xPiTi/pillex-main/CAD/4.png

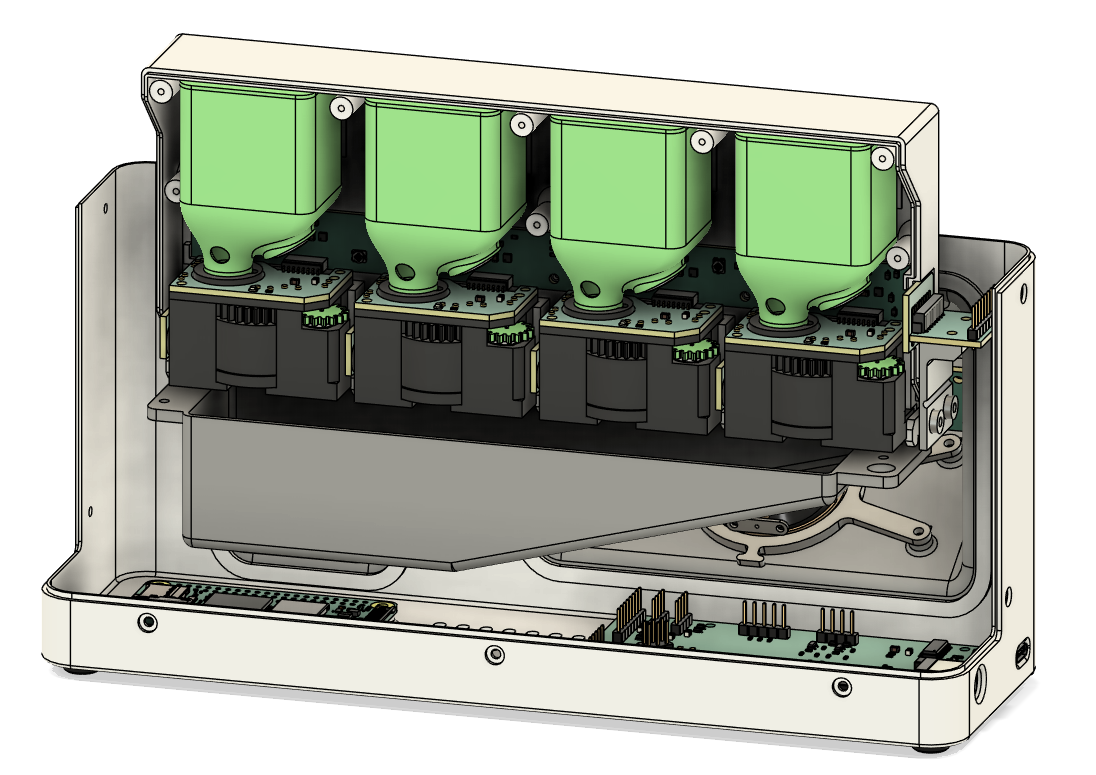
CAD/4.png
