xPiTi/pillex-main/CAD/5.png

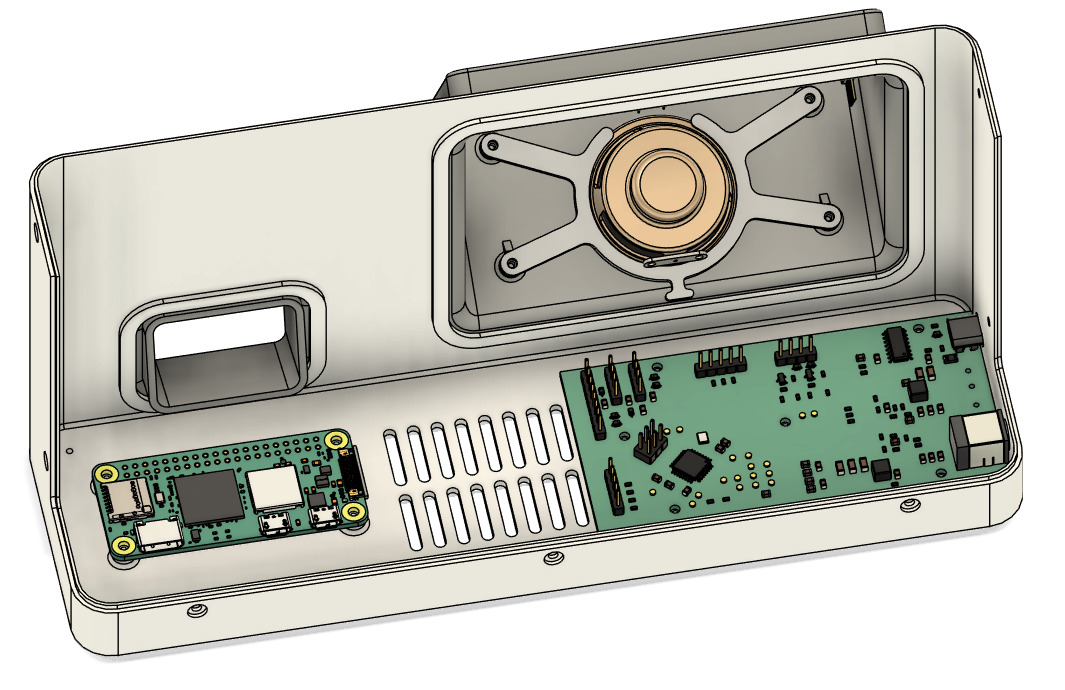
CAD/5.png
