xPiTi/pillex-main/README.md

# Pillex

Submission files for MSc project - Pillex - pill dispensing device

Read more at: https://paw3l.com/projects/pillex/
