xPiTi/pillex-main/CAD/1.png

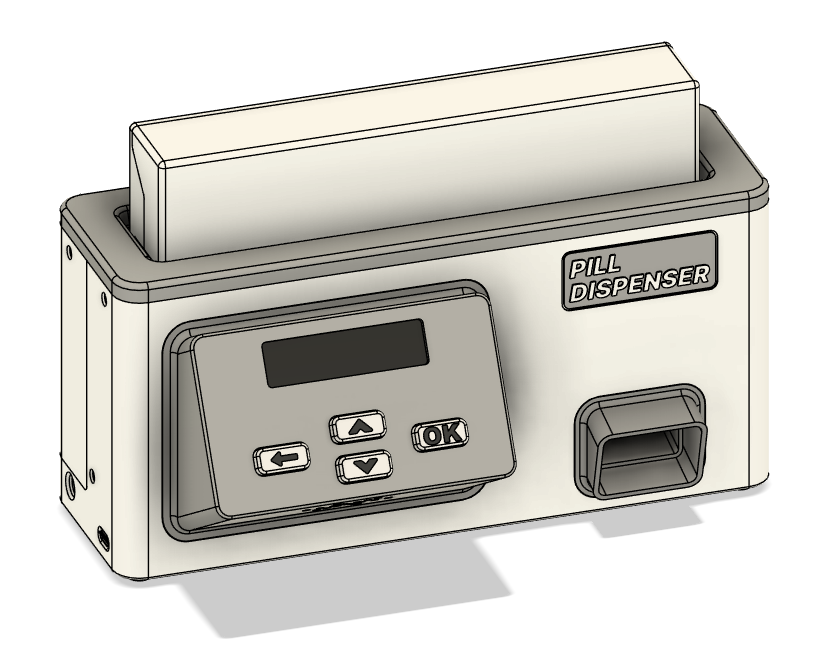
CAD/1.png
