xPiTi/pillex-main/CAD/2.png

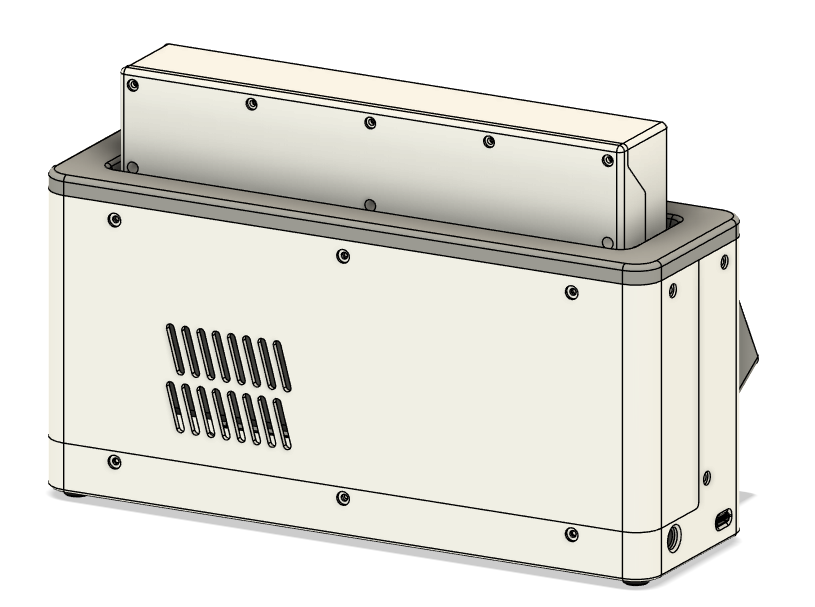
CAD/2.png
