xPiTi/pillex-main/CAD/3.png

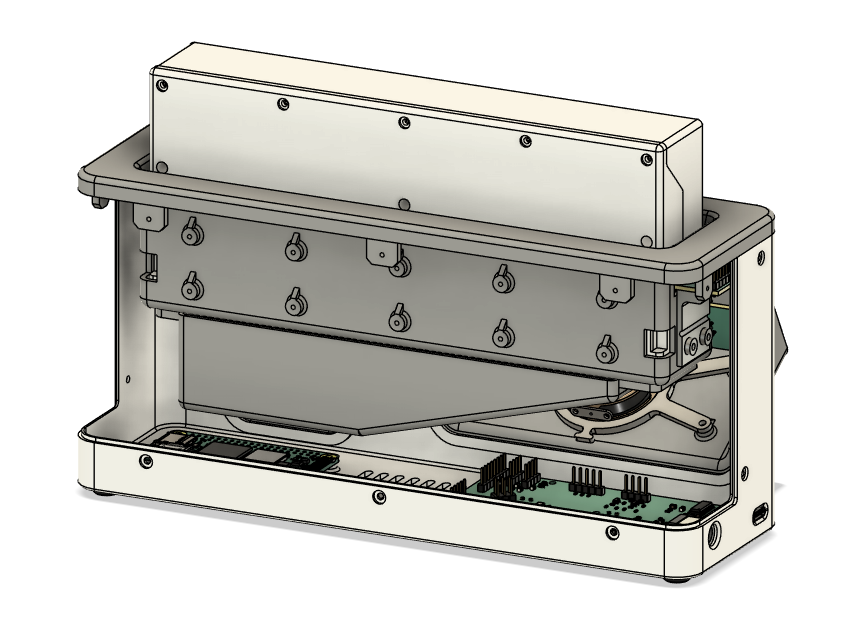
CAD/3.png
