xPiTi/pillex-main/CAD/6.png

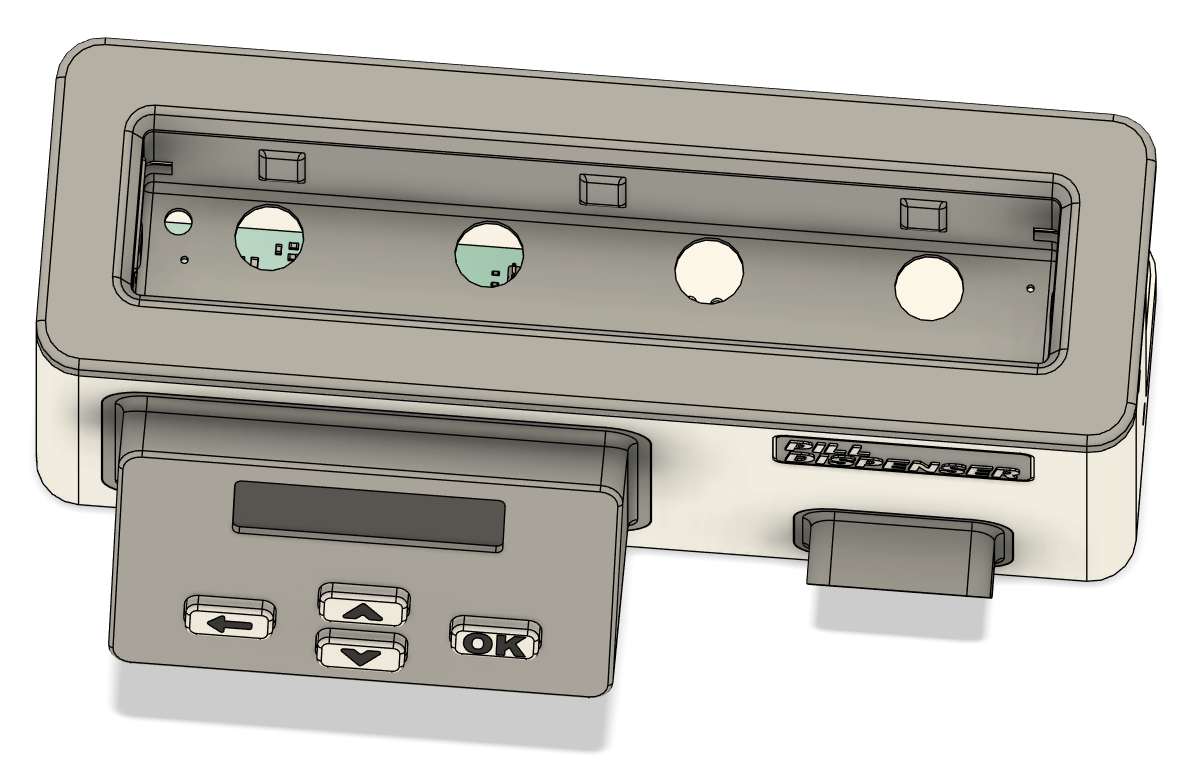
CAD/6.png
