xPiTi/pillex-main/PCB/PillDispenser.kicad_pcb

## KiCad design PCB/PillDispenser.kicad_pcb (2025-11-02)

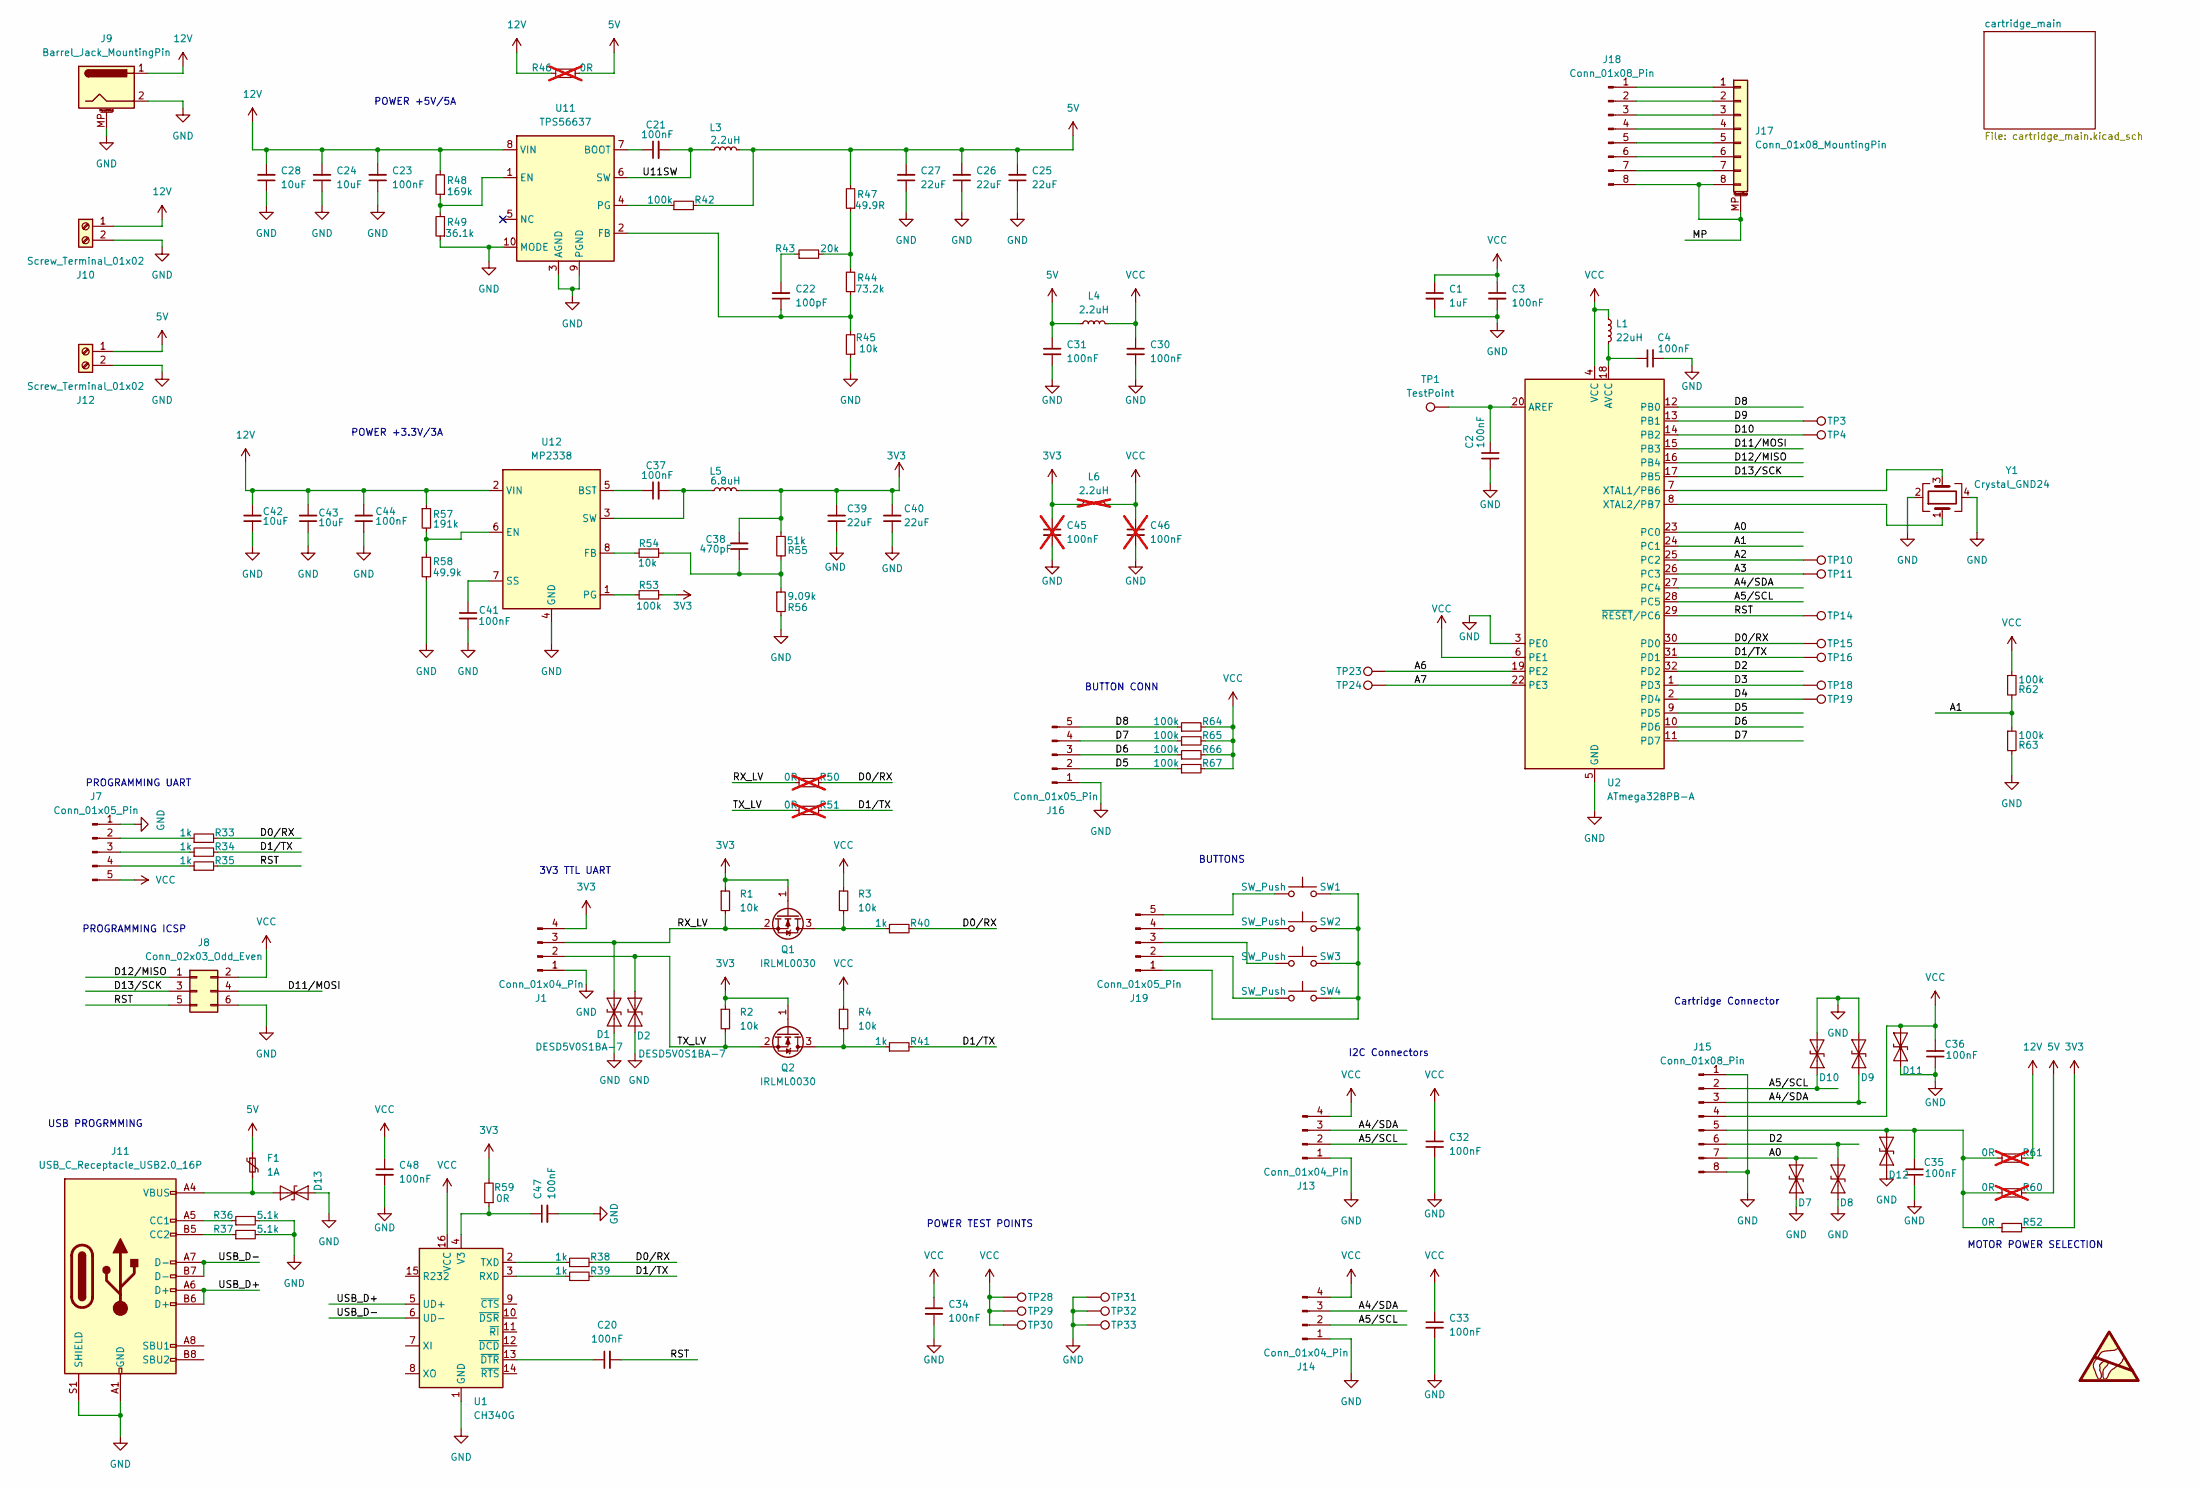
[picture p7: schematic PillDispenser.kicad_sch, Pill Dispenser]

Parts:
C1: 1uF; C_0805_2012Metric_Pad1.18x1.45mm_HandSolder
C2, C3, C4, C20, C21, C23, C30, C31, C32, C33, C34, C35, C36, C37, C41, C44, C47, C48: 100nF; C_0805_2012Metric_Pad1.18x1.45mm_HandSolder
C22: 100pF; C_0805_2012Metric_Pad1.18x1.45mm_HandSolder
C24, C28, C42, C43: 10uF; C_0805_2012Metric_Pad1.18x1.45mm_HandSolder
C25, C26, C27, C39, C40: 22uF; C_1206_3216Metric_Pad1.33x1.80mm_HandSolder
C38: 470pF; C_0805_2012Metric_Pad1.18x1.45mm_HandSolder
C45, C46: 100nF; C_0805_2012Metric_Pad1.18x1.45mm_HandSolder; not fitted
D1, D2, D7, D8, D9, D10, D11, D12, D13: DESD5V0S1BA-7; D_SOD-323
F1: 1A; D_1206_3216Metric_Pad1.42x1.75mm_HandSolder
J1, J13, J14: Conn_01x04_Pin; PinHeader_1x04_P2.54mm_Vertical
J7, J16, J19: Conn_01x05_Pin; PinHeader_1x05_P2.54mm_Vertical
J8: Conn_02x03_Odd_Even; PinHeader_2x03_P2.54mm_Vertical
J9: Barrel_Jack_MountingPin; BarrelJack_CUI_PJ-063AH_Horizontal
J10, J12: Screw_Terminal_01x02; Altech_AK100_1x02_P5.00mm
J11: USB_C_Receptacle_USB2.0_16P; USB_C_Receptacle_GCT_USB4085
J15, J18: Conn_01x08_Pin; PinHeader_1x08_P2.54mm_Vertical
J17: Conn_01x08_MountingPin; 009155008852006
L1: 22uH; L_0805_2012Metric_Pad1.15x1.40mm_HandSolder
L3: 2.2uH; L_Coilcraft_XAL4030-XXX
L4: 2.2uH; L_0805_2012Metric_Pad1.15x1.40mm_HandSolder
L5: 6.8uH; L_Coilcraft_XAL4030-XXX
L6: 2.2uH; L_0805_2012Metric_Pad1.15x1.40mm_HandSolder; not fitted
Q1, Q2: IRLML0030; SOT-23
R1, R2, R3, R4, R45, R54: 10k; R_0603_1608Metric_Pad0.98x0.95mm_HandSolder
R33, R34, R35, R38, R39, R40, R41: 1k; R_0603_1608Metric_Pad0.98x0.95mm_HandSolder
R36, R37: 5.1k; R_0603_1608Metric_Pad0.98x0.95mm_HandSolder
R42, R53, R62, R63, R64, R65, R66, R67: 100k; R_0603_1608Metric_Pad0.98x0.95mm_HandSolder
R43: 20k; R_0603_1608Metric_Pad0.98x0.95mm_HandSolder
R44: 73.2k; R_0603_1608Metric_Pad0.98x0.95mm_HandSolder
R46, R50, R51, R60, R61: 0R; R_0603_1608Metric_Pad0.98x0.95mm_HandSolder; not fitted
R47: 49.9R; R_0603_1608Metric_Pad0.98x0.95mm_HandSolder
R48: 169k; R_0603_1608Metric_Pad0.98x0.95mm_HandSolder
R49: 36.1k; R_0603_1608Metric_Pad0.98x0.95mm_HandSolder
R52, R59: 0R; R_0603_1608Metric_Pad0.98x0.95mm_HandSolder
R55: 51k; R_0603_1608Metric_Pad0.98x0.95mm_HandSolder
R56: 9.09k; R_0603_1608Metric_Pad0.98x0.95mm_HandSolder
R57: 191k; R_0603_1608Metric_Pad0.98x0.95mm_HandSolder
R58: 49.9k; R_0603_1608Metric_Pad0.98x0.95mm_HandSolder
SW1, SW2, SW3, SW4: SW_Push; SW_PUSH_6mm_H5mm
TP1, TP3, TP4, TP10, TP11, TP14, TP15, TP16, TP18, TP19, TP23, TP24, TP28, TP29, TP30, TP31, TP32, TP33: TestPoint; TestPoint_Pad_D1.5mm_3D_Model
U1: CH340G; SOIC-16_3.9x9.9mm_P1.27mm
U2: ATmega328PB-A; TQFP-32_7x7mm_P0.8mm
U11: TPS56637; Texas_VQFN-HR_3.1x3.1mm_P1mm_RPA0010A
U12: MP2338; SOT-583-8
Y1: Crystal_GND24; Crystal_SMD_Abracon_ABM8G-4Pin_3.2x2.5mm

Connections:
3V3: C38.2, C39.2, C40.2, C45.1, J1.4, L5.2, L6.1, Q1.1 (G), Q2.1 (G), R1.1, R2.1, R52.2, R53.1, R55.1, R59.2
5V: C25.2, C26.2, C27.2, C31.1, F1.1, J12.1, L3.2, L4.1, R42.2, R46.2, R47.2, R60.2
12V: C23.2, C24.2, C28.2, C42.2, C43.2, C44.2, J9.1, J10.1, R46.1, R48.2, R57.1, R61.2, U11.8 (VIN), U12.2 (VIN)
/A0: D7.2 (A2), J15.7, U2.23 (PC0)
/A1: R62.2, R63.1, U2.24 (PC1)
/A2: TP10.1, U2.25 (PC2)
/A3: TP11.1, U2.26 (PC3)
/A4/SDA: D9.1 (A1), J13.3, J14.3, J15.3, U2.27 (PC4)
/A5/SCL: D10.1 (A1), J13.2, J14.2, J15.2, U2.28 (PC5)
/A6: TP23.1, U2.19 (PE2)
/A7: TP24.1, U2.22 (PE3)
/D0/RX: R33.2, R38.2, R40.2, R50.2, TP15.1, U2.30 (PD0)
/D1/TX: R34.2, R39.2, R41.2, R51.2, TP16.1, U2.31 (PD1)
/D2: D8.2 (A2), J15.6, U2.32 (PD2)
/D3: TP18.1, U2.1 (PD3)
/D4: TP19.1, U2.2 (PD4)
/D5: J16.2, R67.1, U2.9 (PD5)
/D6: J16.3, R66.1, U2.10 (PD6)
/D7: J16.4, R65.1, U2.11 (PD7)
/D8: J16.5, R64.1, U2.12 (PB0)
/D9: TP3.1, U2.13 (PB1)
/D10: TP4.1, U2.14 (PB2)
/D11/MOSI: J8.4, U2.15 (PB3)
/D12/MISO: J8.1, U2.16 (PB4)
/D13/SCK: J8.3, U2.17 (PB5)
/MP: J17.8, J17.MP (MountPin), J18.8
/RST: C20.2, J8.5, R35.2, TP14.1, U2.29 (~RESET/PC6)
/RX_LV: D1.2 (A2), J1.3, Q1.2 (S), R1.2, R50.1
/TX_LV: D2.2 (A2), J1.2, Q2.2 (S), R2.2, R51.1
/U11SW: C21.2, L3.1, U11.6 (SW)
/USB_D+: J11.A6 (D+), J11.B6 (D+), U1.5 (UD+)
/USB_D-: J11.A7 (D-), J11.B7 (D-), U1.6 (UD-)
GND: C1.2, C2.1, C3.2, C4.2, C23.1, C24.1, C25.1, C26.1, C27.1, C28.1, C30.2, C31.2, C32.2, C33.2, C34.2, C35.1, C36.1, C39.1, C40.1, C41.2, C42.1, C43.1, C44.1, C45.2, C46.2, C47.2, C48.2, D1.1 (A1), D2.1 (A1), D7.1 (A1), D8.1 (A1), D9.2 (A2), D10.2 (A2), D11.1 (A1), D12.1 (A1), D13.1 (A1), J1.1, J7.1, J8.6, J9.2, J9.MP (MountPin), J10.2, J11.A1 (GND), J11.A12 (GND), J11.B1 (GND), J11.B12 (GND), J11.S1 (SHIELD), J12.2, J13.1, J14.1, J15.1, J15.8, J16.1, R36.2, R37.2, R45.1, R49.1, R56.2, R58.2, R63.2, TP31.1, TP32.1, TP33.1, U1.1 (GND), U2.3 (PE0), U2.5 (GND), U2.21 (GND), U11.3 (AGND), U11.9 (PGND), U11.10 (MODE), U12.4 (GND), Y1.2, Y1.4
unnamed: C22.2, R43.1
unnamed: C38.1, R54.1, R55.2, R56.1
unnamed: C35.2, D12.2 (A2), J15.5, R52.1, R60.1, R61.1
unnamed: D13.2 (A2), F1.2, J11.A4 (VBUS), J11.A9 (VBUS), J11.B4 (VBUS), J11.B9 (VBUS)
unnamed: J7.2, R33.1
unnamed: J7.3, R34.1
unnamed: J7.4, R35.1
unnamed: J11.A5 (CC1), R36.1
unnamed: J11.B5 (CC2), R37.1
unnamed: J17.1, J18.1
unnamed: J17.2, J18.2
unnamed: J17.3, J18.3
unnamed: J17.4, J18.4
unnamed: J17.5, J18.5
unnamed: J17.6, J18.6
unnamed: J17.7, J18.7
unnamed: J19.1, SW1.2, SW2.2, SW3.2, SW4.2
unnamed: J19.2, SW4.1
unnamed: J19.3, SW3.1
unnamed: J19.4, SW2.1
unnamed: J19.5, SW1.1
unnamed: Q1.3 (D), R3.2, R40.1
unnamed: Q2.3 (D), R4.2, R41.1
unnamed: R43.2, R44.2, R47.1
unnamed: R39.1, U1.3 (RXD)
unnamed: R38.1, U1.2 (TXD)
unnamed: C47.1, R59.1, U1.4 (V3)
unnamed: C20.1, U1.13 (~DTR)
unnamed: C2.2, TP1.1, U2.20 (AREF)
unnamed: C4.1, L1.2, U2.18 (AVCC)
unnamed: U2.7 (XTAL1/PB6), Y1.3
unnamed: U2.8 (XTAL2/PB7), Y1.1
unnamed: C21.1, U11.7 (BOOT)
unnamed: R48.1, R49.2, U11.1 (EN)
unnamed: C22.1, R44.1, R45.2, U11.2 (FB)
unnamed: R42.1, U11.4 (PG)
unnamed: C37.1, U12.5 (BST)
unnamed: R57.2, R58.1, U12.6 (EN)
unnamed: R54.2, U12.8 (FB)
unnamed: R53.2, U12.1 (PG)
unnamed: C41.1, U12.7 (SS)
unnamed: C37.2, L5.1, U12.3 (SW)
VCC: C1.1, C3.1, C30.1, C32.1, C33.1, C34.1, C36.2, C46.1, C48.1, D11.2 (A2), J7.5, J8.2, J13.4, J14.4, J15.4, L1.1, L4.2, L6.2, R3.1, R4.1, R62.1, R64.2, R65.2, R66.2, R67.2, TP28.1, TP29.1, TP30.1, U1.16 (VCC), U2.4 (VCC), U2.6 (PE1)

Notes on the sheet:
PROGRAMMING UART
BUTTON CONN
BUTTONS
I2C Connectors
Cartridge Connector
MOTOR POWER SELECTION
POWER +3.3V/3A
POWER TEST POINTS
USB PROGRMMING
POWER +5V/5A
3V3 TTL UART
PROGRAMMING ICSP

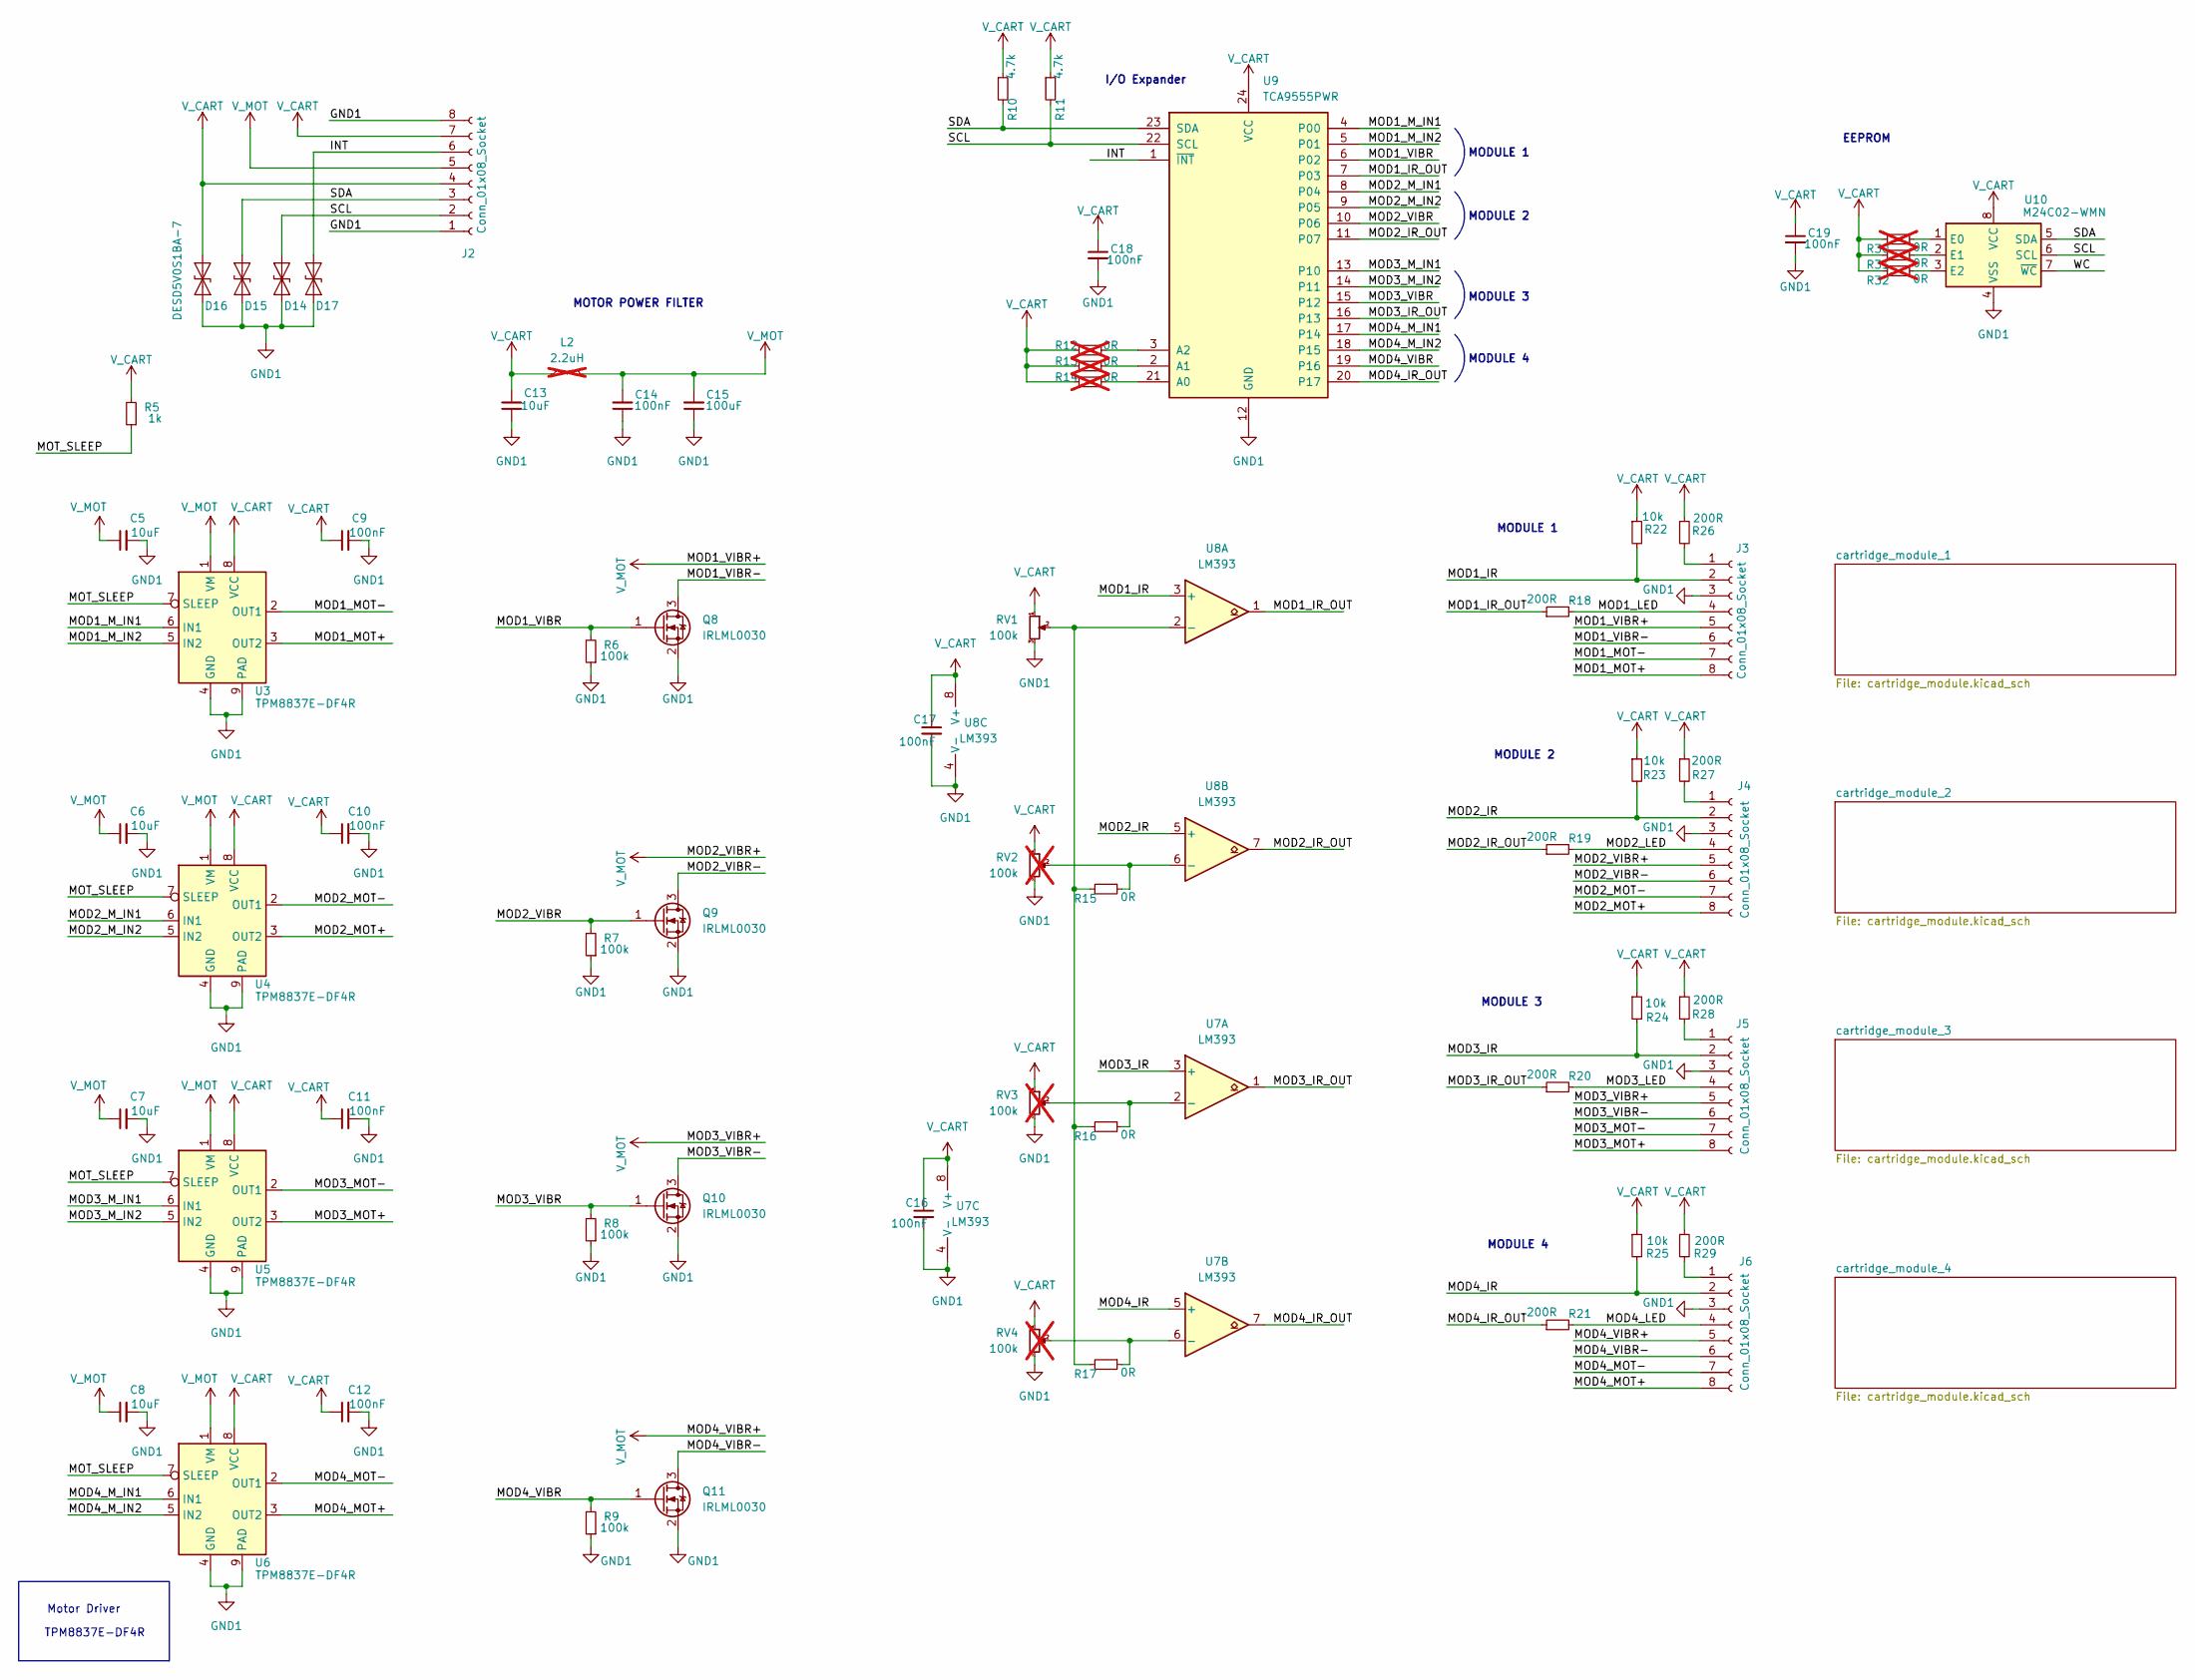
[picture p8: schematic cartridge_main.kicad_sch, Pill Dispenser]

Parts:
C5, C6, C7, C8, C13: 10uF; C_0805_2012Metric_Pad1.18x1.45mm_HandSolder
C9, C10, C11, C12, C14, C16, C17, C18, C19: 100nF; C_0805_2012Metric_Pad1.18x1.45mm_HandSolder
C15: 100uF; C_1206_3216Metric_Pad1.33x1.80mm_HandSolder
D14, D15, D16, D17: DESD5V0S1BA-7; D_SOD-323
J2: Conn_01x08_Socket; PCB_Contacts_8pin
J3, J4, J5, J6: Conn_01x08_Socket; PinSocket_1x08_P1.27mm_Vertical
L2: 2.2uH; L_1210_3225Metric_Pad1.42x2.65mm_HandSolder; not fitted
Q8, Q9, Q10, Q11: IRLML0030; SOT-23
R5: 1k; R_0603_1608Metric_Pad0.98x0.95mm_HandSolder
R6, R7, R8, R9: 100k; R_0603_1608Metric_Pad0.98x0.95mm_HandSolder
R10, R11: 4.7k; R_0603_1608Metric_Pad0.98x0.95mm_HandSolder
R12, R13, R14, R30, R31, R32: 0R; R_0603_1608Metric_Pad0.98x0.95mm_HandSolder; not fitted
R15, R16, R17: 0R; R_0603_1608Metric_Pad0.98x0.95mm_HandSolder
R18, R19, R20, R21, R26, R27, R28, R29: 200R; R_0603_1608Metric_Pad0.98x0.95mm_HandSolder
R22, R23, R24, R25: 10k; R_0603_1608Metric_Pad0.98x0.95mm_HandSolder
RV1: 100k; Potentiometer_Bourns_TC33X_Vertical
RV2, RV3, RV4: 100k; Potentiometer_Bourns_TC33X_Vertical; not fitted
U3, U4, U5, U6: TPM8837E-DF4R; DFN-8-1EP_2x2mm_P0.5mm_EP1.05x1.75mm_hand_solder
U7, U8: LM393; SOIC-8_3.9x4.9mm_P1.27mm
U9: TCA9555PWR; TSSOP-24_4.4x7.8mm_P0.65mm
U10: M24C02-WMN; SOIC-8_3.9x4.9mm_P1.27mm

Connections:
/cartridge_main/INT: D17.2 (A2), J2.6, U9.1 (~INT)
/cartridge_main/MOD1_IR: J3.2, R22.2, U8.3 (+)
/cartridge_main/MOD1_IR_OUT: R18.1, U8.1, U9.7 (P03)
/cartridge_main/MOD1_LED: J3.4, R18.2
/cartridge_main/MOD1_MOT+: J3.8, U3.3 (OUT2)
/cartridge_main/MOD1_MOT-: J3.7, U3.2 (OUT1)
/cartridge_main/MOD1_M_IN1: U3.6 (IN1), U9.4 (P00)
/cartridge_main/MOD1_M_IN2: U3.5 (IN2), U9.5 (P01)
/cartridge_main/MOD1_VIBR: Q8.1 (G), R6.2, U9.6 (P02)
/cartridge_main/MOD1_VIBR-: J3.6, Q8.3 (D)
/cartridge_main/MOD2_IR: J4.2, R23.2, U8.5 (+)
/cartridge_main/MOD2_IR_OUT: R19.1, U8.7, U9.11 (P07)
/cartridge_main/MOD2_LED: J4.4, R19.2
/cartridge_main/MOD2_MOT+: J4.8, U4.3 (OUT2)
/cartridge_main/MOD2_MOT-: J4.7, U4.2 (OUT1)
/cartridge_main/MOD2_M_IN1: U4.6 (IN1), U9.8 (P04)
/cartridge_main/MOD2_M_IN2: U4.5 (IN2), U9.9 (P05)
/cartridge_main/MOD2_VIBR: Q9.1 (G), R7.2, U9.10 (P06)
/cartridge_main/MOD2_VIBR-: J4.6, Q9.3 (D)
/cartridge_main/MOD3_IR: J5.2, R24.2, U7.3 (+)
/cartridge_main/MOD3_IR_OUT: R20.1, U7.1, U9.16 (P13)
/cartridge_main/MOD3_LED: J5.4, R20.2
/cartridge_main/MOD3_MOT+: J5.8, U5.3 (OUT2)
/cartridge_main/MOD3_MOT-: J5.7, U5.2 (OUT1)
/cartridge_main/MOD3_M_IN1: U5.6 (IN1), U9.13 (P10)
/cartridge_main/MOD3_M_IN2: U5.5 (IN2), U9.14 (P11)
/cartridge_main/MOD3_VIBR: Q10.1 (G), R8.2, U9.15 (P12)
/cartridge_main/MOD3_VIBR-: J5.6, Q10.3 (D)
/cartridge_main/MOD4_IR: J6.2, R25.2, U7.5 (+)
/cartridge_main/MOD4_IR_OUT: R21.1, U7.7, U9.20 (P17)
/cartridge_main/MOD4_LED: J6.4, R21.2
/cartridge_main/MOD4_MOT+: J6.8, U6.3 (OUT2)
/cartridge_main/MOD4_MOT-: J6.7, U6.2 (OUT1)
/cartridge_main/MOD4_M_IN1: U6.6 (IN1), U9.17 (P14)
/cartridge_main/MOD4_M_IN2: U6.5 (IN2), U9.18 (P15)
/cartridge_main/MOD4_VIBR: Q11.1 (G), R9.2, U9.19 (P16)
/cartridge_main/MOD4_VIBR-: J6.6, Q11.3 (D)
/cartridge_main/MOT_SLEEP: R5.1, U3.7 (SLEEP), U4.7 (SLEEP), U5.7 (SLEEP), U6.7 (SLEEP)
/cartridge_main/SCL: D14.2 (A2), J2.2, R11.2, U9.22 (SCL), U10.6 (SCL)
/cartridge_main/SDA: D15.2 (A2), J2.3, R10.2, U9.23 (SDA), U10.5 (SDA)
/cartridge_main/WC: U10.7 (~WC)
GND1: C5.2, C6.2, C7.2, C8.2, C9.2, C10.2, C11.2, C12.2, C13.1, C14.1, C15.1, C16.2, C17.2, C18.2, C19.2, D14.1 (A1), D15.1 (A1), D16.1 (A1), D17.1 (A1), J2.1, J2.8, J3.3, J4.3, J5.3, J6.3, Q8.2 (S), Q9.2 (S), Q10.2 (S), Q11.2 (S), R6.1, R7.1, R8.1, R9.1, RV1.3, RV2.3, RV3.3, RV4.3, U3.4 (GND), U3.9 (PAD), U4.4 (GND), U4.9 (PAD), U5.4 (GND), U5.9 (PAD), U6.4 (GND), U6.9 (PAD), U7.4 (V-), U8.4 (V-), U9.12 (GND), U10.4 (VSS)
unnamed: J3.1, R26.2
unnamed: J4.1, R27.2
unnamed: J5.1, R28.2
unnamed: J6.1, R29.2
unnamed: R16.1, RV3.2, U7.2 (-)
unnamed: R17.1, RV4.2, U7.6 (-)
unnamed: R15.2, R16.2, R17.2, RV1.2, U8.2 (-)
unnamed: R15.1, RV2.2, U8.6 (-)
unnamed: R14.1, U9.21 (A0)
unnamed: R13.1, U9.2 (A1)
unnamed: R12.1, U9.3 (A2)
unnamed: R30.1, U10.1 (E0)
unnamed: R31.1, U10.2 (E1)
unnamed: R32.1, U10.3 (E2)
V_CART: C9.1, C10.1, C11.1, C12.1, C13.2, C16.1, C17.1, C18.1, C19.1, D16.2 (A2), J2.4, J2.7, L2.1, R5.2, R10.1, R11.1, R12.2, R13.2, R14.2, R22.1, R23.1, R24.1, R25.1, R26.1, R27.1, R28.1, R29.1, R30.2, R31.2, R32.2, RV1.1, RV2.1, RV3.1, RV4.1, U3.8 (VCC), U4.8 (VCC), U5.8 (VCC), U6.8 (VCC), U7.8 (V+), U8.8 (V+), U9.24 (VCC), U10.8 (VCC)
V_MOT: C5.1, C6.1, C7.1, C8.1, C14.2, C15.2, J2.5, J3.5, J4.5, J5.5, J6.5, L2.2, U3.1 (VM), U4.1 (VM), U5.1 (VM), U6.1 (VM)

Notes on the sheet:
Motor Driver
MODULE 1
TPM8837E-DF4R
MODULE 3
MOTOR POWER FILTER
I/O Expander
MODULE 4
MODULE 2
EEPROM

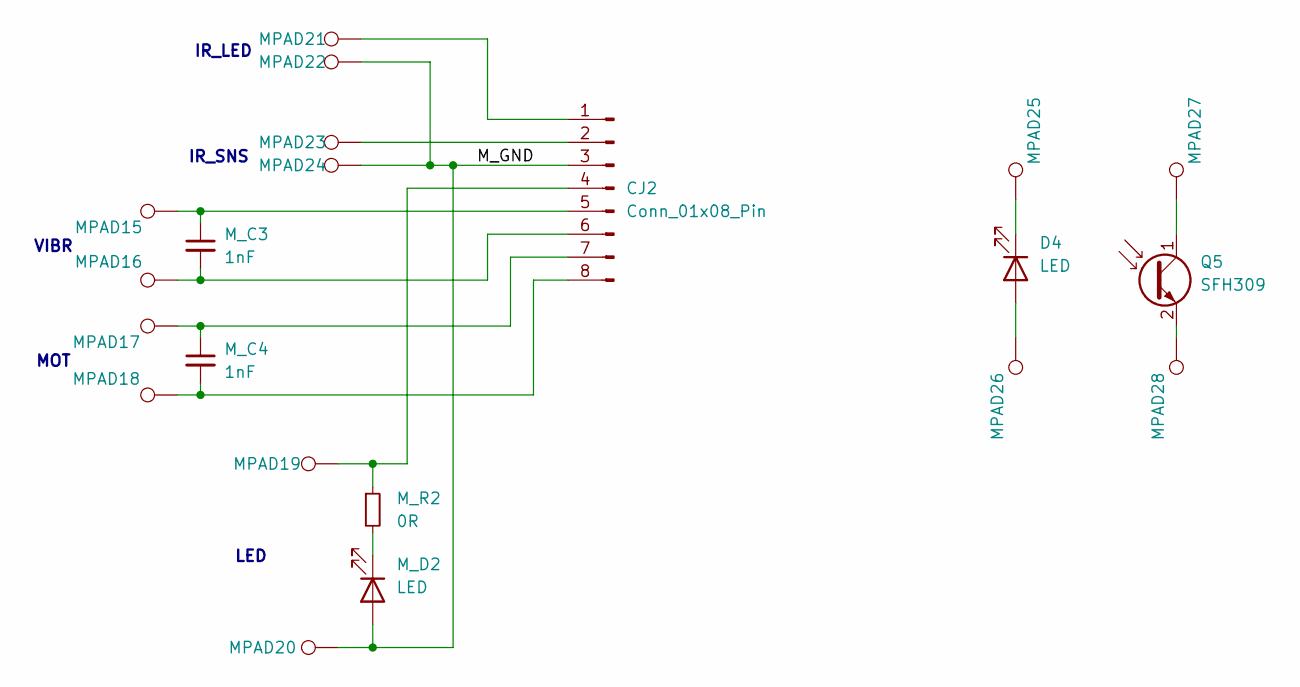
[picture p9: schematic cartridge_module.kicad_sch, Pill Dispenser]

Parts:
CJ2: Conn_01x08_Pin; PinHeader_1x08_P1.27mm_Horizontal
D4: LED; LED_D3.0mm_Clear
MPAD15, MPAD16, MPAD17, MPAD18, MPAD19, MPAD20, MPAD21, MPAD22, MPAD23, MPAD24, MPAD25, MPAD26, MPAD27, MPAD28: TestPoint; TestPoint_Pad_D1.5mm_3D_Model
M_C3, M_C4: 1nF; C_0805_2012Metric_Pad1.18x1.45mm_HandSolder
M_D2: LED; LED_0805_2012Metric_Pad1.15x1.40mm_HandSolder
M_R2: 0R; R_0603_1608Metric_Pad0.98x0.95mm_HandSolder
Q5: SFH309; LED_D3.0mm_Clear

Connections:
/cartridge_main/cartridge_module_2/M_GND: CJ2.3, MPAD20.1, MPAD22.1, MPAD24.1, M_D2.2 (A)
unnamed: CJ2.1, MPAD21.1
unnamed: CJ2.2, MPAD23.1
unnamed: CJ2.4, MPAD19.1, M_R2.1
unnamed: CJ2.5, MPAD15.1, M_C3.1
unnamed: CJ2.6, MPAD16.1, M_C3.2
unnamed: CJ2.7, MPAD17.1, M_C4.1
unnamed: CJ2.8, MPAD18.1, M_C4.2
unnamed: D4.2 (A), MPAD26.1
unnamed: D4.1 (K), MPAD25.1
unnamed: M_D2.1 (K), M_R2.2
unnamed: MPAD27.1, Q5.1 (C)
unnamed: MPAD28.1, Q5.2 (E)

Parts of its further copies:
CJ1, CJ3, CJ4: Conn_01x08_Pin; PinHeader_1x08_P1.27mm_Horizontal
D3, D5, D6: LED; LED_D3.0mm_Clear
MPAD1, MPAD2, MPAD3, MPAD4, MPAD5, MPAD6, MPAD7, MPAD8, MPAD9, MPAD10, MPAD11, MPAD12, MPAD13, MPAD14, MPAD29, MPAD30, MPAD31, MPAD32, MPAD33, MPAD34, MPAD35, MPAD36, MPAD37, MPAD38, MPAD39, MPAD40, MPAD41, MPAD42, MPAD43, MPAD44, MPAD45, MPAD46, MPAD47, MPAD48, MPAD49, MPAD50, MPAD51, MPAD52, MPAD53, MPAD54, MPAD55, MPAD56: TestPoint; TestPoint_Pad_D1.5mm_3D_Model
M_C1, M_C2, M_C5, M_C6, M_C7, M_C8: 1nF; C_0805_2012Metric_Pad1.18x1.45mm_HandSolder
M_D1, M_D3, M_D4: LED; LED_0805_2012Metric_Pad1.15x1.40mm_HandSolder
M_R1, M_R3, M_R4: 0R; R_0603_1608Metric_Pad0.98x0.95mm_HandSolder
Q4, Q6, Q7: SFH309; LED_D3.0mm_Clear

Connections of its further copies:
/cartridge_main/cartridge_module_1/M_GND: CJ1.3, MPAD6.1, MPAD8.1, MPAD10.1, M_D1.2 (A)
/cartridge_main/cartridge_module_3/M_GND: CJ3.3, MPAD34.1, MPAD36.1, MPAD38.1, M_D3.2 (A)
/cartridge_main/cartridge_module_4/M_GND: CJ4.3, MPAD48.1, MPAD50.1, MPAD52.1, M_D4.2 (A)
unnamed: CJ1.1, MPAD7.1
unnamed: CJ1.2, MPAD9.1
unnamed: CJ1.4, MPAD5.1, M_R1.1
unnamed: CJ1.5, MPAD1.1, M_C1.1
unnamed: CJ1.6, MPAD2.1, M_C1.2
unnamed: CJ1.7, MPAD3.1, M_C2.1
unnamed: CJ1.8, MPAD4.1, M_C2.2
unnamed: CJ3.1, MPAD35.1
unnamed: CJ3.2, MPAD37.1
unnamed: CJ3.4, MPAD33.1, M_R3.1
unnamed: CJ3.5, MPAD29.1, M_C5.1
unnamed: CJ3.6, MPAD30.1, M_C5.2
unnamed: CJ3.7, MPAD31.1, M_C6.1
unnamed: CJ3.8, MPAD32.1, M_C6.2
unnamed: CJ4.1, MPAD49.1
unnamed: CJ4.2, MPAD51.1
unnamed: CJ4.4, MPAD47.1, M_R4.1
unnamed: CJ4.5, MPAD43.1, M_C7.1
unnamed: CJ4.6, MPAD44.1, M_C7.2
unnamed: CJ4.7, MPAD45.1, M_C8.1
unnamed: CJ4.8, MPAD46.1, M_C8.2
unnamed: D3.2 (A), MPAD12.1
unnamed: D3.1 (K), MPAD11.1
unnamed: D5.2 (A), MPAD40.1
unnamed: D5.1 (K), MPAD39.1
unnamed: D6.2 (A), MPAD54.1
unnamed: D6.1 (K), MPAD53.1
unnamed: M_D1.1 (K), M_R1.2
unnamed: M_D3.1 (K), M_R3.2
unnamed: M_D4.1 (K), M_R4.2
unnamed: MPAD13.1, Q4.1 (C)
unnamed: MPAD14.1, Q4.2 (E)
unnamed: MPAD41.1, Q6.1 (C)
unnamed: MPAD42.1, Q6.2 (E)
unnamed: MPAD55.1, Q7.1 (C)
unnamed: MPAD56.1, Q7.2 (E)

Notes on the sheet:
IR_SNS
IR_LED
VIBR
LED
MOT

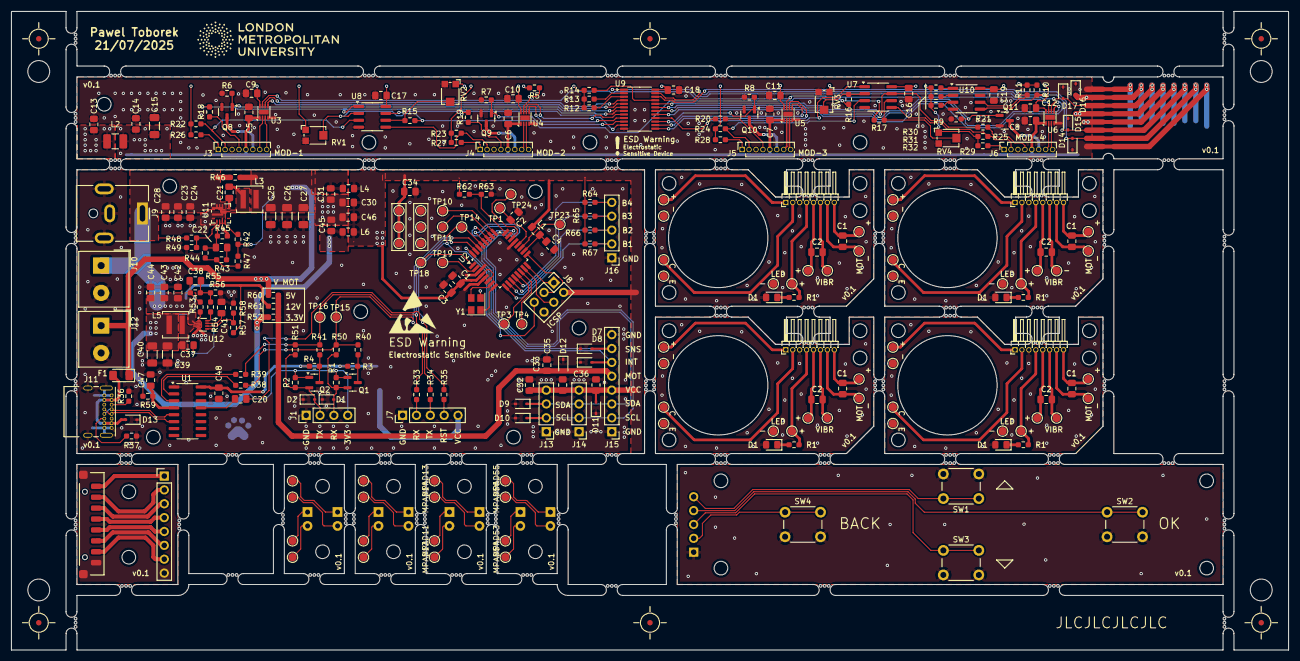
[picture p10: board PillDispenser.kicad_pcb from above]

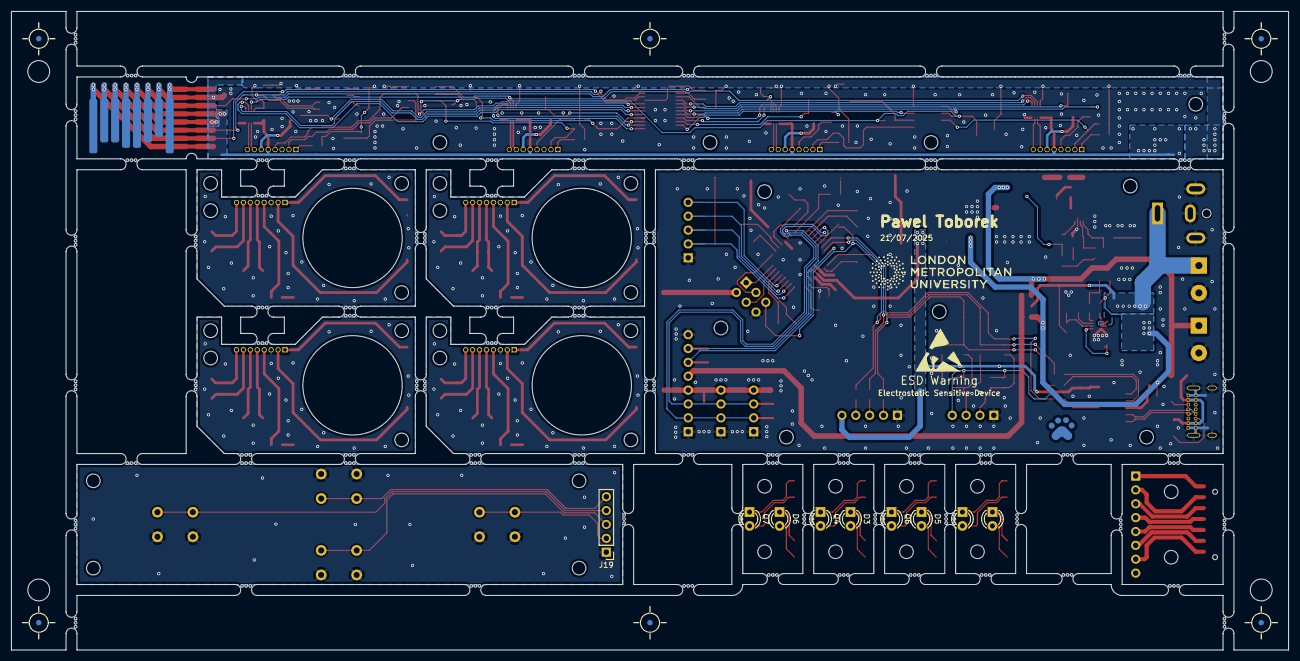
[picture p11: board PillDispenser.kicad_pcb from below]

Board: 2 copper layers, 234.0 x 117.0 mm, 350 parts (10 on the bottom side), 185 nets.

Other parts of the board:
mouse-bite-2mm-slot, mouse-bite-2mm-slot#6, mouse-bite-2mm-slot#8, mouse-bite-2mm-slot#9, mouse-bite-2mm-slot#10, mouse-bite-2mm-slot#14, mouse-bite-2mm-slot#22, mouse-bite-2mm-slot#26, mouse-bite-2mm-slot#29, mouse-bite-2mm-slot#34, mouse-bite-2mm-slot#35, mouse-bite-2mm-slot#36, mouse-bite-2mm-slot#40, mouse-bite-2mm-slot#44, mouse-bite-2mm-slot#47, mouse-bite-2mm-slot#49, mouse-bite-2mm-slot#50, mouse-bite-2mm-slot#51, mouse-bite-2mm-slot#52, mouse-bite-2mm-slot#53, mouse-bite-2mm-slot#61, mouse-bite-2mm-slot#62, mouse-bite-2mm-slot#64: VAL**; mouse-bite-2mm-slot
mouse-bite-2mm-slot#2, mouse-bite-2mm-slot#3, mouse-bite-2mm-slot#4, mouse-bite-2mm-slot#5, mouse-bite-2mm-slot#7, mouse-bite-2mm-slot#11, mouse-bite-2mm-slot#12, mouse-bite-2mm-slot#13, mouse-bite-2mm-slot#15, mouse-bite-2mm-slot#16, mouse-bite-2mm-slot#17, mouse-bite-2mm-slot#18, mouse-bite-2mm-slot#19, mouse-bite-2mm-slot#20, mouse-bite-2mm-slot#21, mouse-bite-2mm-slot#23, mouse-bite-2mm-slot#24, mouse-bite-2mm-slot#25, mouse-bite-2mm-slot#27, mouse-bite-2mm-slot#28, mouse-bite-2mm-slot#30, mouse-bite-2mm-slot#31, mouse-bite-2mm-slot#32, mouse-bite-2mm-slot#33, mouse-bite-2mm-slot#37, mouse-bite-2mm-slot#38, mouse-bite-2mm-slot#39, mouse-bite-2mm-slot#41, mouse-bite-2mm-slot#42, mouse-bite-2mm-slot#43, mouse-bite-2mm-slot#45, mouse-bite-2mm-slot#46, mouse-bite-2mm-slot#48, mouse-bite-2mm-slot#54, mouse-bite-2mm-slot#55, mouse-bite-2mm-slot#56, mouse-bite-2mm-slot#57, mouse-bite-2mm-slot#58, mouse-bite-2mm-slot#59, mouse-bite-2mm-slot#60, mouse-bite-2mm-slot#63, mouse-bite-2mm-slot#65, mouse-bite-2mm-slot#66, mouse-bite-2mm-slot#67, mouse-bite-2mm-slot#68: VAL**; mouse-bite-2mm-slot_one_side
